duongtruongdp/ND-PicoDMX-System/firmware/v2.0.2-STABLE/V2.0.2_STABLE_FINAL_NOTES.md

# ND DMX NODE 4U — v2.0.2 Stable Final

This release is rebuilt from the known-working v2.0.1 firmware.

## 1. DMX Engine

- Removed the experimental `spin_try_lock()` and direct hardware-register
  spinlock helper used by earlier v2.0.2 test builds.
- Uses the official Pico SDK `spin_lock_blocking()` / `spin_unlock()` pair.
- Core 1 now enters the shared-buffer lock only when a new 40 Hz DMX frame is
  due, instead of claiming the lock continuously in every Core 1 loop.
- Added a 35 ms PIO/FIFO timeout and automatic state-machine recovery.
- Preserved the original PIO program, 105 us BREAK, 14 us MAB, 513-byte DMX
  frame, four output pins, and approximately 40 Hz frame schedule.
- Core 1 loop and heartbeat diagnostics use atomic counters.
- Added a controlled watchdog reboot if Core 1 stops producing heartbeat for
  three consecutive seconds.

## 2. MCU Temperature

The temperature feature has been completely removed from:

- ADC initialization and runtime;
- diagnostics structure;
- REST API;
- dashboard interface.

This avoids the unusable ADC subsystem on the tested OEM RP2040 board.

## 3. System Uptime

- Uses the RP2040 64-bit hardware timer `time_us_64()`.
- The authoritative uptime resets only when the MCU loses power or reboots.
- The browser stores the latest uptime snapshot in `localStorage`.
- After a hard refresh, the dashboard restores the continuing value while
  waiting for the node API, then synchronizes to the node value.

## 4. Web Dashboard Loading

- The dashboard HTML is gzip-compressed inside the firmware.
- Transfer size is reduced from about 34 KB to about 9 KB.
- The browser may cache the static dashboard for one hour.
- `/api/status` remains live and uncached.

## 5. Network Input Safety

- Added strict sACN property-length and packet-boundary validation.
- Malformed or truncated sACN packets are rejected before reading DMX slots.

## Validation completed in this environment

- Dashboard JavaScript passed `node --check`.
- Temperature code and API fields are fully removed.
- Old experimental `spin_try_lock`, `spin_unlock_unsafe`, and custom lock
  helper are absent.
- The generated file has not been compiled with the exact Arduino-Pico board
  package and Ethernet library installed on the user's Mac, and has not been
  tested on the physical node.
